kks3851/PowerHouseSurveillance/Poster.JPG

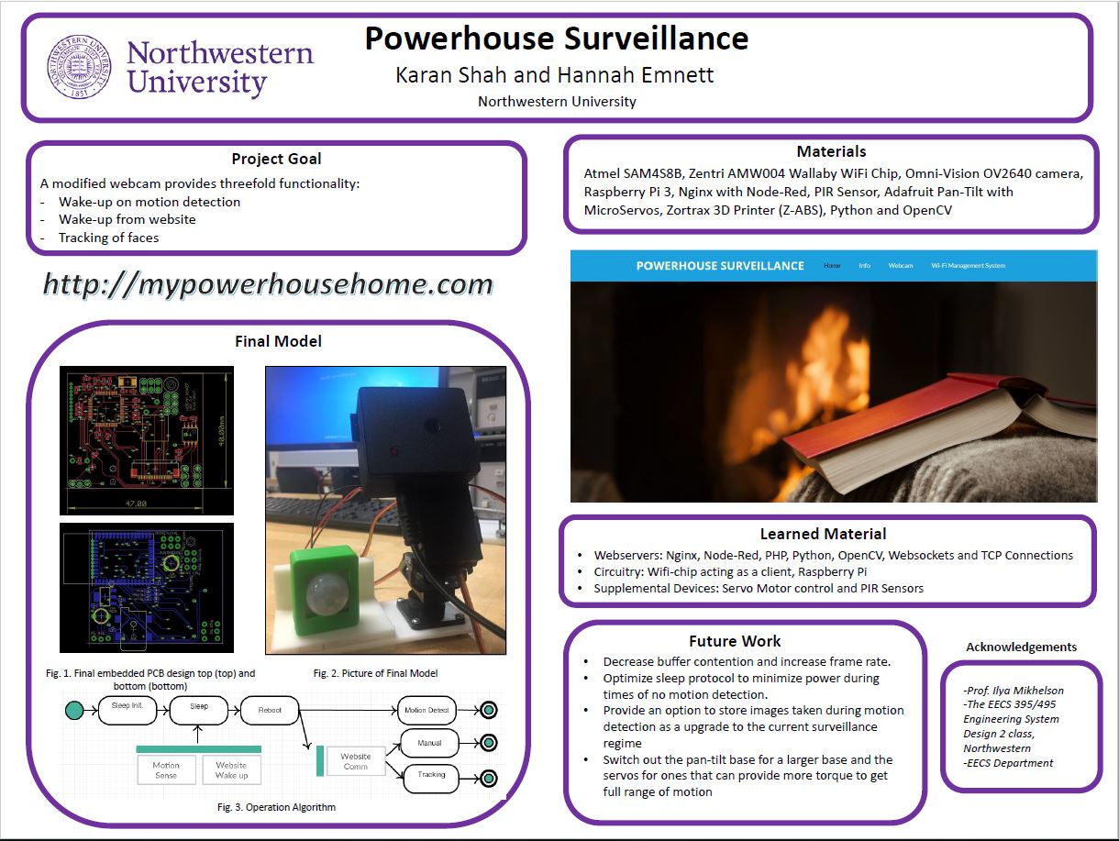
Poster.JPG
