kks3851/PowerHouseSurveillance/EmbeddedDesign.JPG

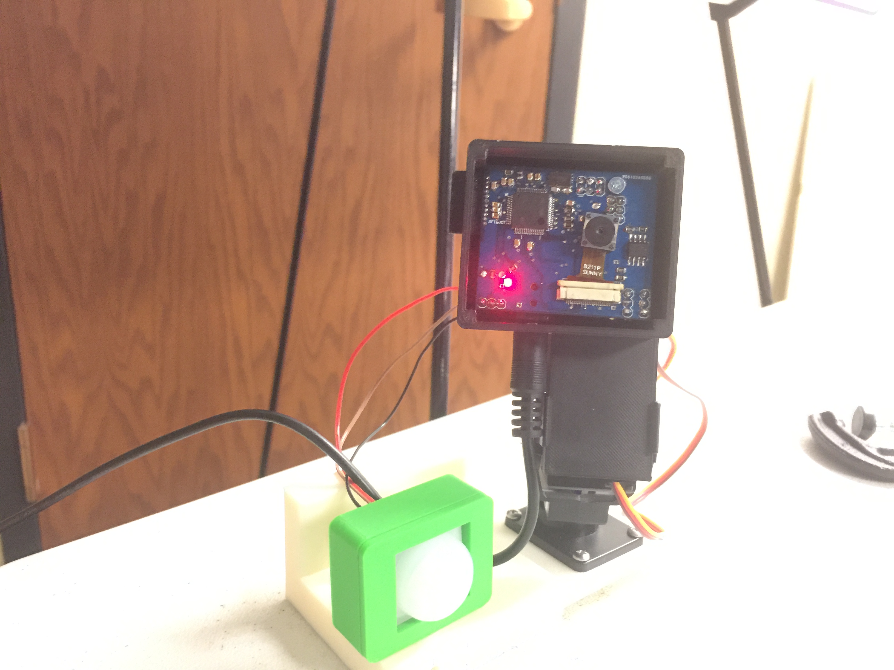
EmbeddedDesign.JPG
