kks3851/PowerHouseSurveillance/README.md

# Power-House-Surveillance 

Webcam for tracking of faces, and system wake up from motion detection and website
Project Made in EECS 495 - Engineering System Design 2, Spring 2017 at Northwestern University
