kks3851/PowerHouseSurveillance/Poster - Power House Survelliance.pdf

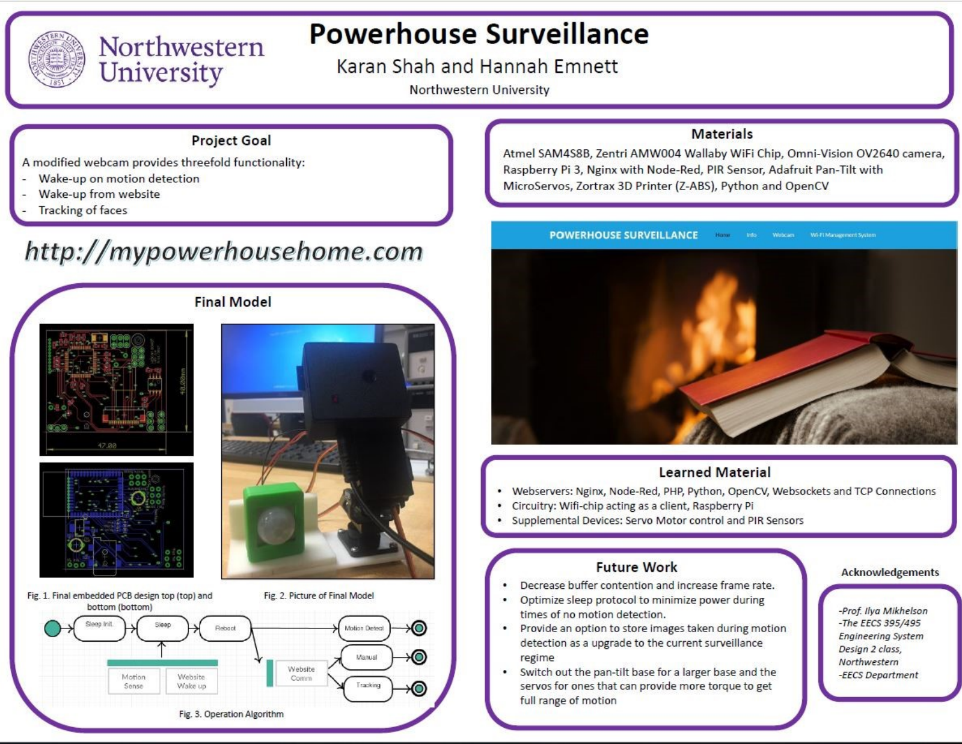
[picture p3: page 1]
