kks3851/PowerHouseSurveillance/Design - top.JPG

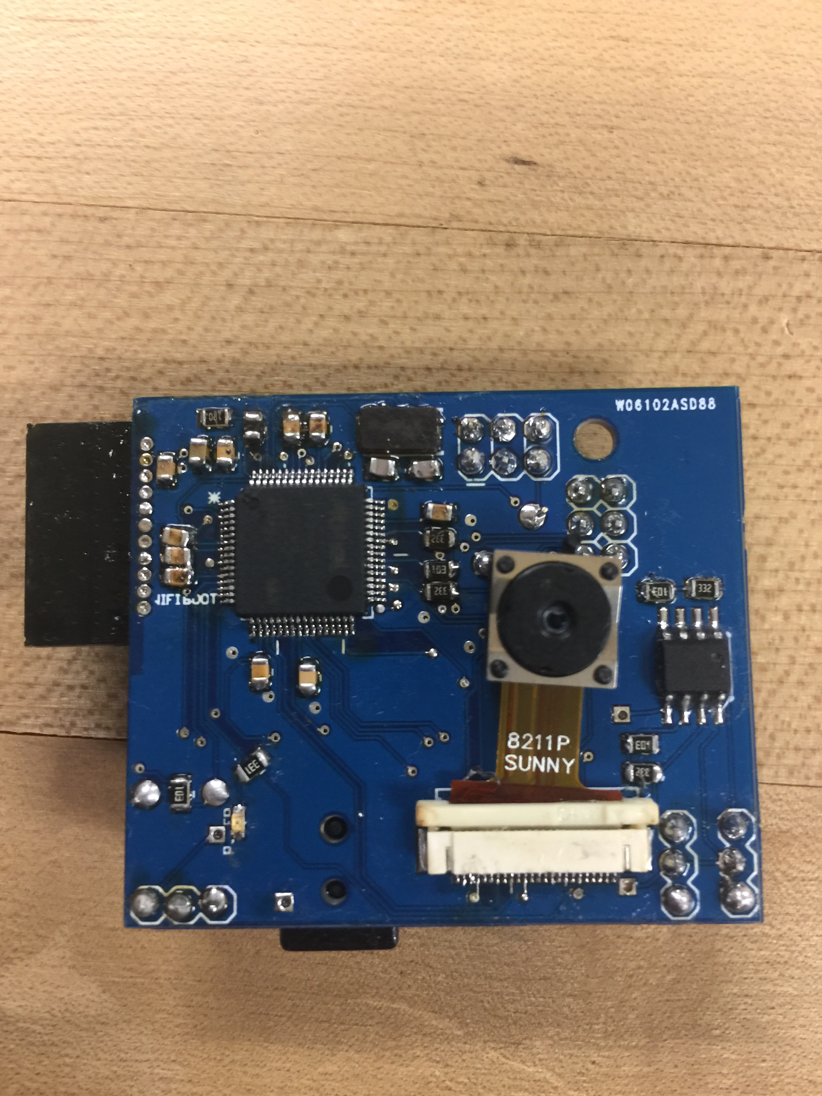
Design - top.JPG
