kks3851/PowerHouseSurveillance/Final Design.JPG

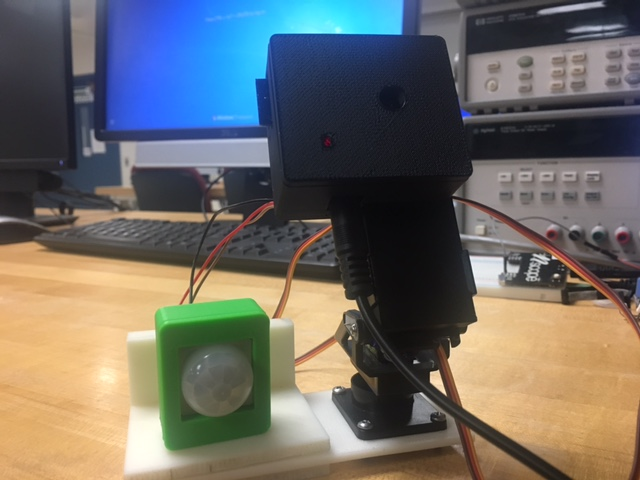
Final Design.JPG
