kks3851/PowerHouseSurveillance/Website.JPG

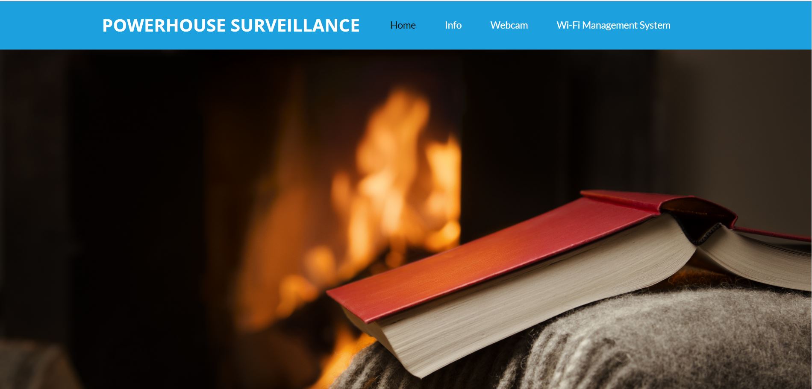
Website.JPG
