kks3851/PowerHouseSurveillance/website/home.JPG

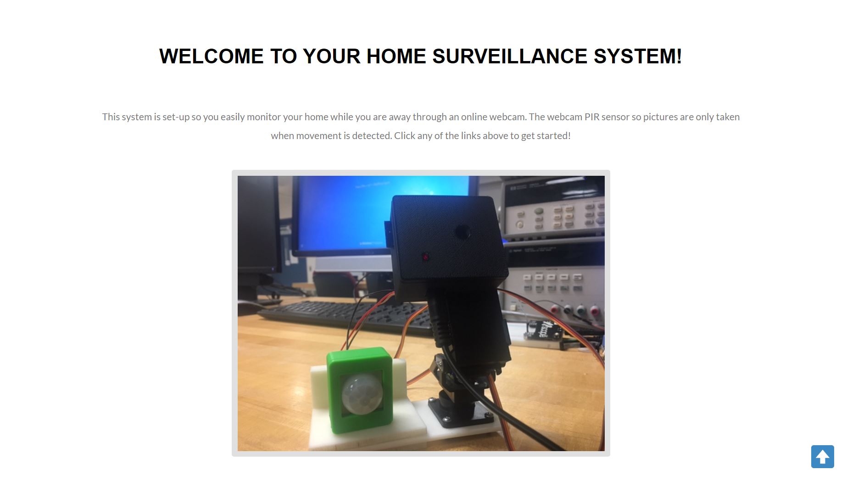
website/home.JPG
