kks3851/PowerHouseSurveillance/website/images/final.JPG

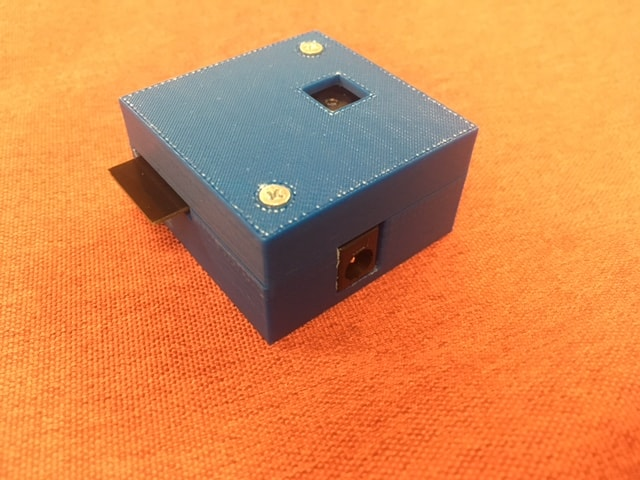
website/images/final.JPG
