kks3851/PowerHouseSurveillance/website/info.JPG

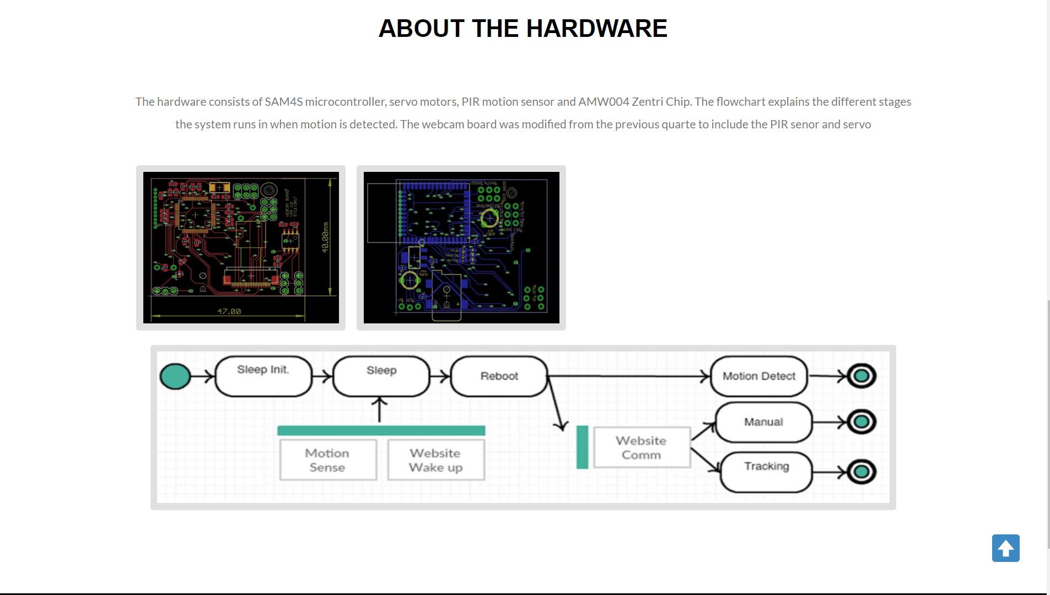
website/info.JPG
