kks3851/PowerHouseSurveillance/website/webcam1.JPG

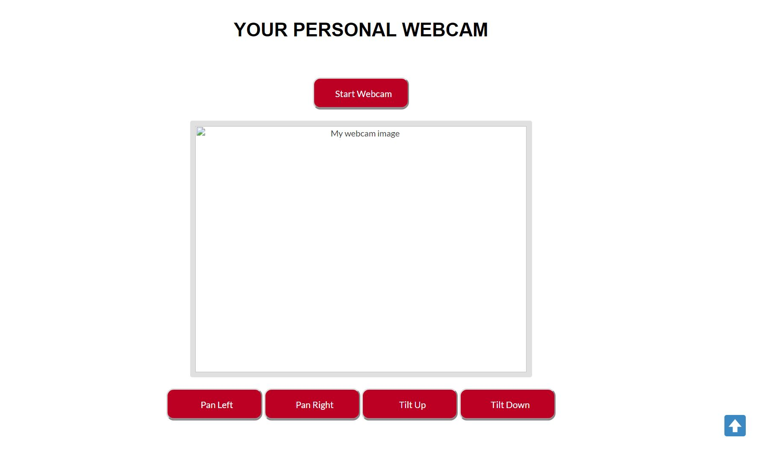
website/webcam1.JPG
