kks3851/PowerHouseSurveillance/CaseV3.stl

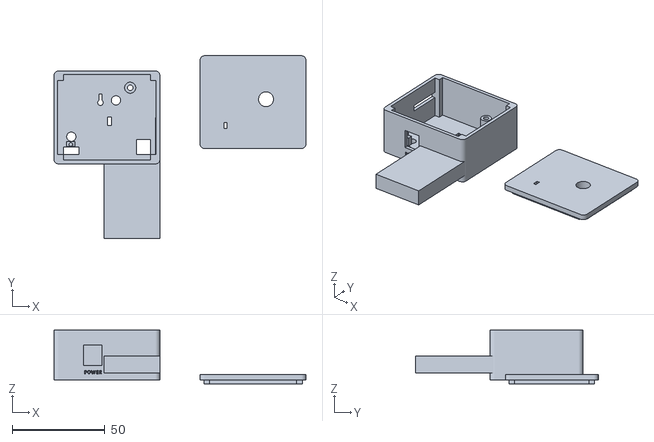
[picture p11: CAD file, 2017-11-30]
CaseV3.stl
135.6 x 98.2 x 29.0
