kks3851/PowerHouseSurveillance/Board/board2.brd

## EAGLE design Board/board2.brd (2017-11-30)

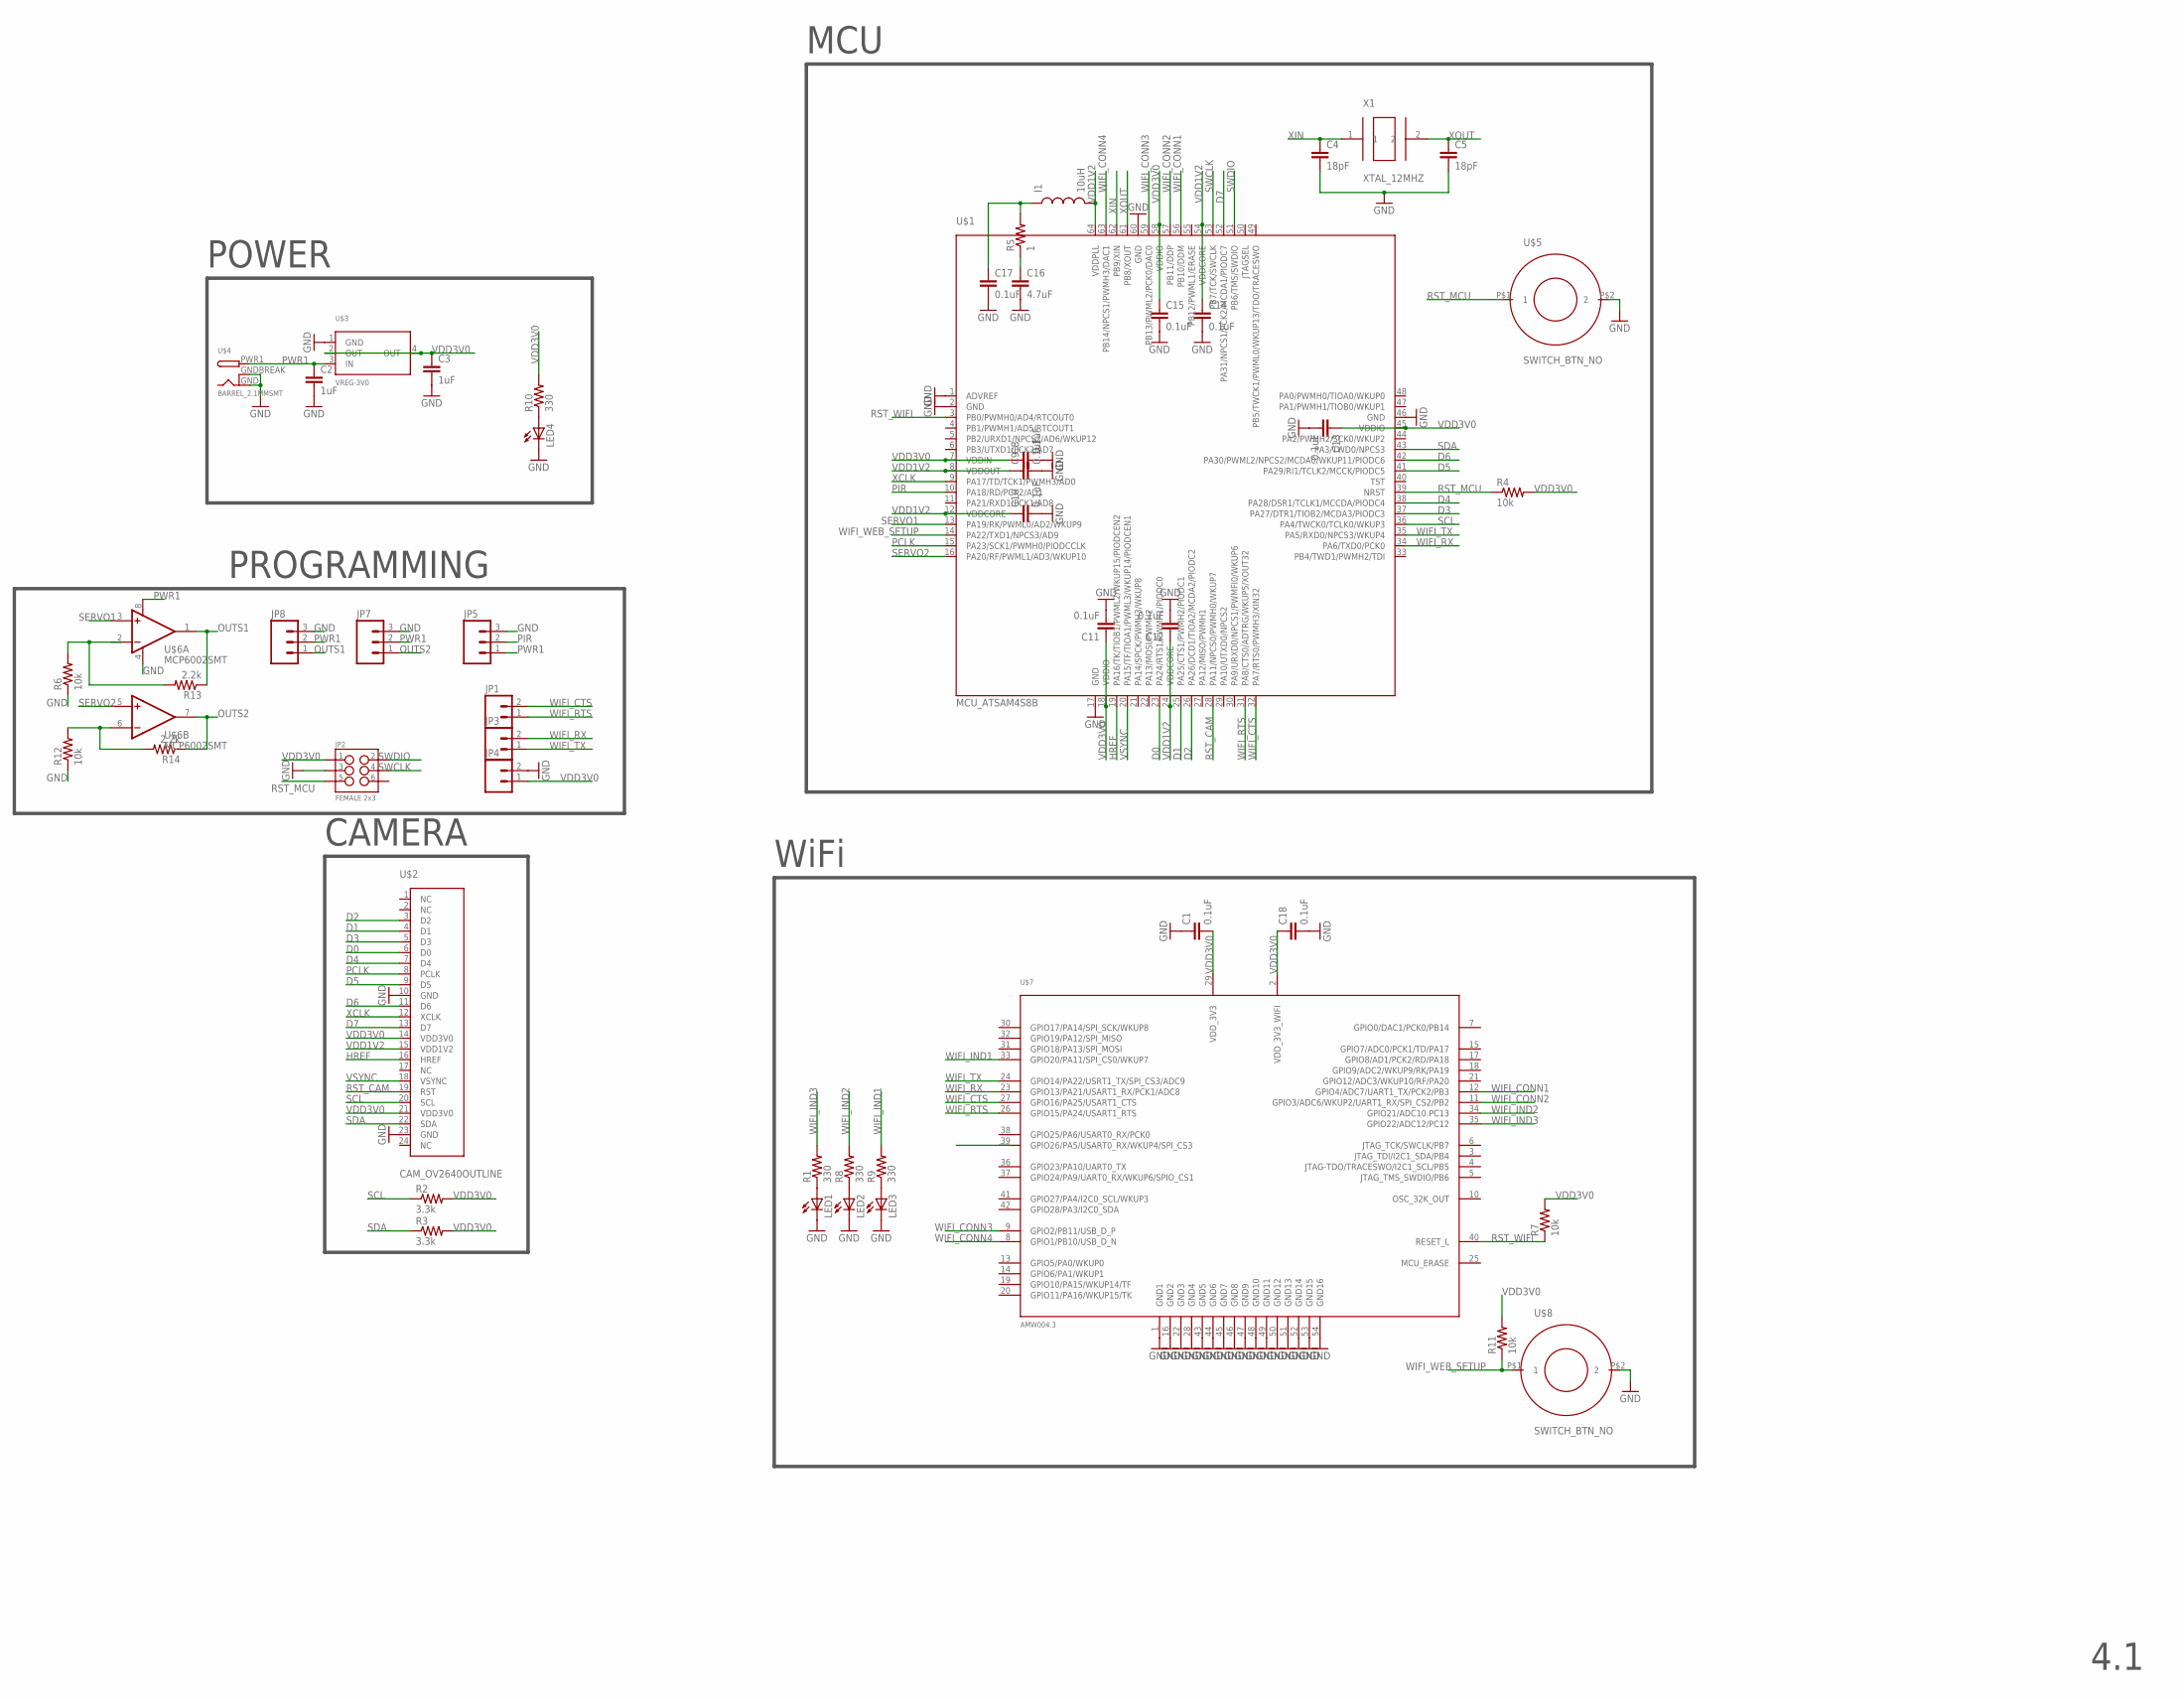
[picture p12: schematic board2.sch]

Parts:
C1, C8, C9, C10, C11, C12, C13, C14, C15, C17, C18: 0.1uF; 0805
C2, C3: 1uF; 0805
C4, C5: 18pF; 0805
C16: 4.7uF; 0805
I1: 10uH; 0805
JP1, JP3, JP4: M02PTH; 1X02
JP2: FEMALE 2x3; 2X3
JP5, JP7, JP8: M03LOCK; 1X03_LOCK
LED1, LED2, LED3, LED4: LED0603; LED-0603
R1, R8, R9, R10: 330; 0805
R2, R3: 3.3k; 0805
R4, R6, R7, R11, R12: 10k; 0805
R5: 1; 0805
R13, R14: 2.2k; 0805
U$1: MCU_ATSAM4S8B; QFP50P1200X1200X160-64N
U$2: CAM_OV2640OUTLINE; CAM_CONN
U$3: VREG-3V0; R-PDSO-G4_TI
U$4: BARREL_2.1MMSMT; DCJACK_2MM_SMT
U$5, U$8: SWITCH_BTN_NO; BTN_2
U$6: MCP6002SMT; SOIC8
U$7: AMW004.3; AMW004
X1: XTAL_12MHZ; ABM7-16.000MHZ-D2Y-T

Connections:
D0: U$1.23 (PA24/RTS1/PWMH1/PIODC0), U$2.6 (D0)
D1: U$1.25 (PA25/CTS1/PWMH2/PIODC1), U$2.4 (D1)
D2: U$1.26 (PA26/DCD1/TIOA2/MCDA2/PIODC2), U$2.3 (D2)
D3: U$1.37 (PA27/DTR1/TIOB2/MCDA3/PIODC3), U$2.5 (D3)
D4: U$1.38 (PA28/DSR1/TCLK1/MCCDA/PIODC4), U$2.7 (D4)
D5: U$1.41 (PA29/RI1/TCLK2/MCCK/PIODC5), U$2.9 (D5)
D6: U$1.42 (PA30/PWML2/NPCS2/MCDA0/WKUP11/PIODC6), U$2.11 (D6)
D7: U$1.52 (PA31/NPCS1/PCK2/MCDA1/PIODC7), U$2.13 (D7)
GND: C1.1, C2.2, C3.2, C4.2, C5.2, C8.2, C9.2, C10.2, C11.2, C12.2, C13.2, C14.2, C15.2, C16.2, C17.2, C18.2, JP2.3, JP4.2, JP5.3, JP7.3, JP8.3, LED1.C, LED2.C, LED3.C, LED4.C, R6.1, R12.1, U$1.1 (ADVREF), U$1.2 (GND), U$1.17 (GND), U$1.46 (GND), U$1.60 (GND), U$2.10 (GND), U$2.23 (GND), U$3.1 (GND), U$4.GND, U$4.GNDBREAK, U$5.P$2 (2), U$6.4 (V-), U$7.1 (GND1), U$7.16 (GND2), U$7.22 (GND3), U$7.28 (GND4), U$7.43 (GND5), U$7.44 (GND6), U$7.45 (GND7), U$7.46 (GND8), U$7.47 (GND9), U$7.48 (GND10), U$7.49 (GND11), U$7.50 (GND12), U$7.51 (GND13), U$7.52 (GND14), U$7.53 (GND15), U$7.54 (GND16), U$8.P$2 (2)
HREF: U$1.19 (PA16/TK/TIOB1/PWML2/WKUP15/PIODCEN2), U$2.16 (HREF)
unnamed: C17.1, I1.1, R5.2
unnamed: C16.1, R5.1
unnamed: LED1.A, R1.1
unnamed: LED2.A, R8.1
unnamed: LED3.A, R9.1
unnamed: LED4.A, R10.1
unnamed: R6.2, R13.2
unnamed: R12.2, R14.2, U$6.6 (-IN)
OUTS1: JP8.1, R13.1, U$6.1 (OUT)
OUTS2: JP7.1, R14.1, U$6.7 (OUT)
PCLK: U$1.15 (PA23/SCK1/PWMH0/PIODCCLK), U$2.8 (PCLK)
PIR: JP5.2, U$1.10 (PA18/RD/PCK2/AD1)
PWR1: C2.1, JP5.1, JP7.2, JP8.2, U$3.3 (IN), U$4.PWR1 (PWR), U$6.8 (V+)
RST_CAM: U$1.28 (PA11/NPCS0/PWMH0/WKUP7), U$2.19 (RST)
RST_MCU: JP2.5, R4.1, U$1.39 (NRST), U$5.P$1 (1)
RST_WIFI: R7.1, U$1.3 (PB0/PWMH0/AD4/RTCOUT0), U$7.40 (RESET_L)
SCL: R2.1, U$1.36 (PA4/TWCK0/TCLK0/WKUP3), U$2.20 (SCL)
SDA: R3.1, U$1.43 (PA3/TWD0/NPCS3), U$2.22 (SDA)
SERVO1: U$1.13 (PA19/RK/PWML0/AD2/WKUP9), U$6.3 (+IN)
SERVO2: U$1.16 (PA20/RF/PWML1/AD3/WKUP10), U$6.5 (+IN)
SWCLK: JP2.4, U$1.53 (PB7/TCK/SWCLK)
SWDIO: JP2.2, U$1.51 (PB6/TMS/SWDIO)
VDD1V2: C9.1, C10.1, C12.1, C14.1, I1.2, U$1.8 (VDDOUT), U$1.12 (VDDCORE), U$1.24 (VDDCORE), U$1.54 (VDDCORE), U$1.64 (VDDPLL), U$2.15 (VDD1V2)
VDD3V0: C1.2, C3.1, C8.1, C11.1, C13.1, C15.1, C18.1, JP2.1, JP4.1, R2.2, R3.2, R4.2, R7.2, R10.2, R11.2, U$1.7 (VDDIN), U$1.18 (VDDIO), U$1.45 (VDDIO), U$1.58 (VDDIO), U$2.14 (VDD3V0), U$2.21 (VDD3V0), U$3.2 (OUT), U$3.4 (OUT), U$7.2 (VDD_3V3_WIFI), U$7.29 (VDD_3V3)
VSYNC: U$1.20 (PA15/TF/TIOA1/PWML3/WKUP14/PIODCEN1), U$2.18 (VSYNC)
WIFI_CONN1: U$1.56 (PB10/DDM), U$7.12 (GPIO4/ADC7/UART1_TX/PCK2/PB3)
WIFI_CONN2: U$1.57 (PB11/DDP), U$7.11 (GPIO3/ADC6/WKUP2/UART1_RX/SPI_CS2/PB2)
WIFI_CONN3: U$1.59 (PB13/PWML2/PCK0/DAC0), U$7.9 (GPIO2/PB11/USB_D_P)
WIFI_CONN4: U$1.63 (PB14/NPCS1/PWMH3/DAC1), U$7.8 (GPIO1/PB10/USB_D_N)
WIFI_CTS: JP1.2, U$1.32 (PA7/RTS0/PWMH3/XIN32), U$7.27 (GPIO16/PA25/USART1_CTS)
WIFI_IND1: R9.2, U$7.33 (GPIO20/PA11/SPI_CS0/WKUP7)
WIFI_IND2: R8.2, U$7.34 (GPIO21/ADC10.PC13)
WIFI_IND3: R1.2, U$7.35 (GPIO22/ADC12/PC12)
WIFI_RTS: JP1.1, U$1.31 (PA8/CTS0/ADTRG/WKUP5/XOUT32), U$7.26 (GPIO15/PA24/USART1_RTS)
WIFI_RX: JP3.2, U$1.34 (PA6/TXD0/PCK0), U$7.23 (GPIO13/PA21/USART1_RX/PCK1/ADC8)
WIFI_TX: JP3.1, U$1.35 (PA5/RXD0/NPCS3/WKUP4), U$7.24 (GPIO14/PA22/USRT1_TX/SPI_CS3/ADC9)
WIFI_WEB_SETUP: R11.1, U$1.14 (PA22/TXD1/NPCS3/AD9), U$8.P$1 (1)
XCLK: U$1.9 (PA17/TD/TCK1/PWMH3/AD0), U$2.12 (XCLK)
XIN: C4.1, U$1.62 (PB9/XIN), X1.1
XOUT: C5.1, U$1.61 (PB8/XOUT), X1.2

Notes on the sheet:
POWER
PROGRAMMING
CAMERA
WiFi
MCU
4.1

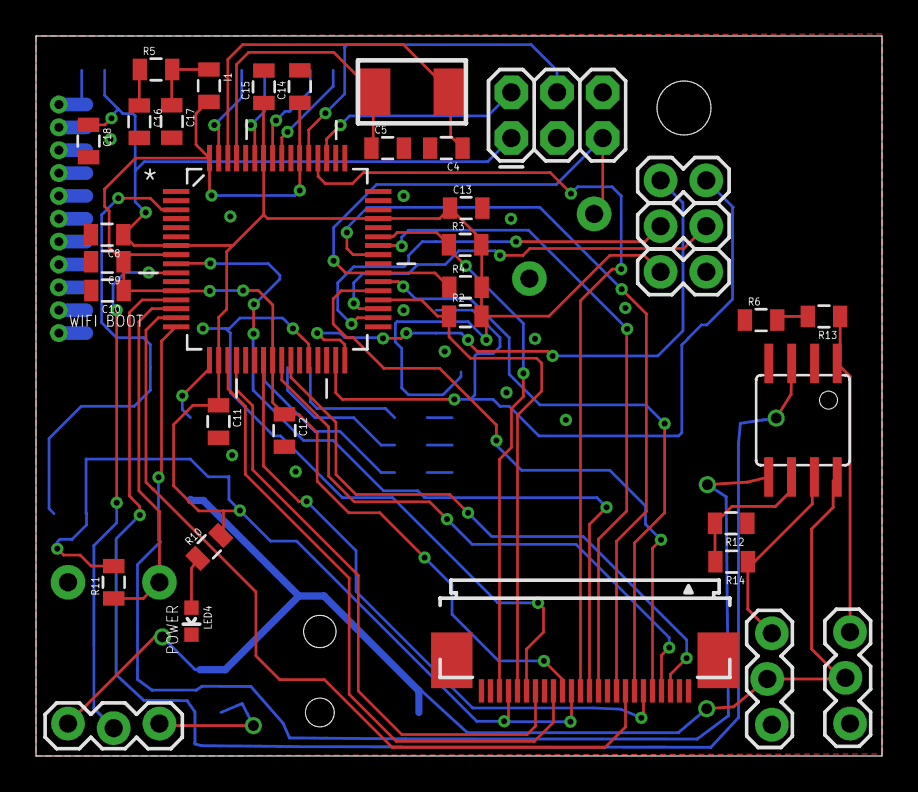
[picture p13: board board2.brd from above]

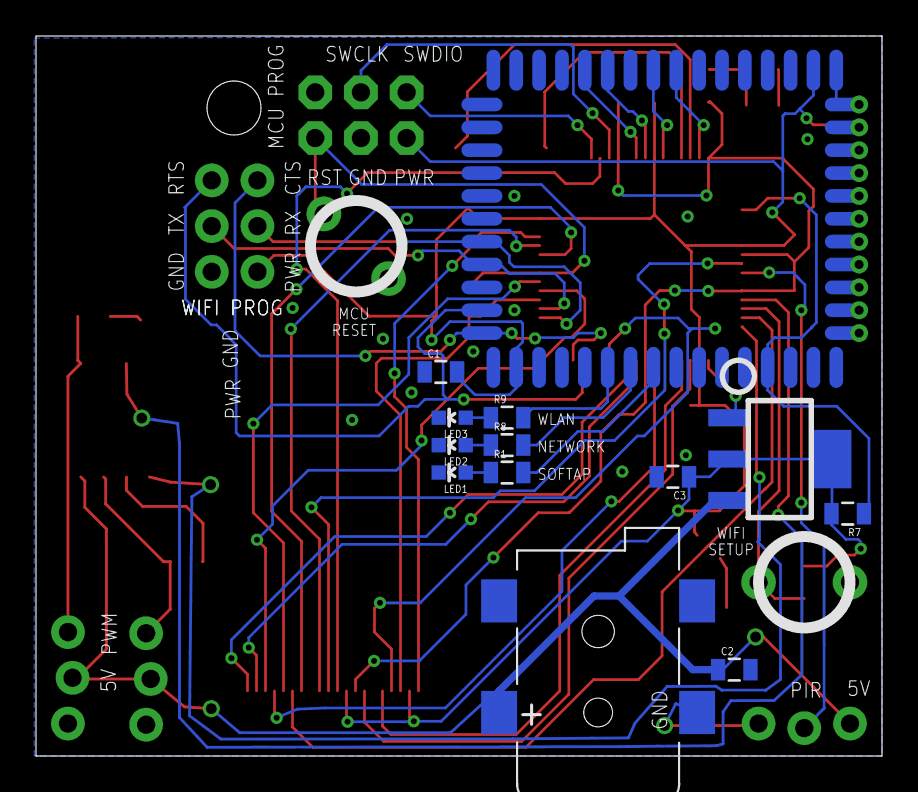
[picture p14: board board2.brd from below]

Board: 2 copper layers, 47.0 x 40.0 mm, 51 parts (15 on the bottom side), 50 nets.
